meklort/kestrel-versa-adapter/kestrel.kicad_pcb

## KiCad design kestrel.kicad_pcb (2021-04-24)

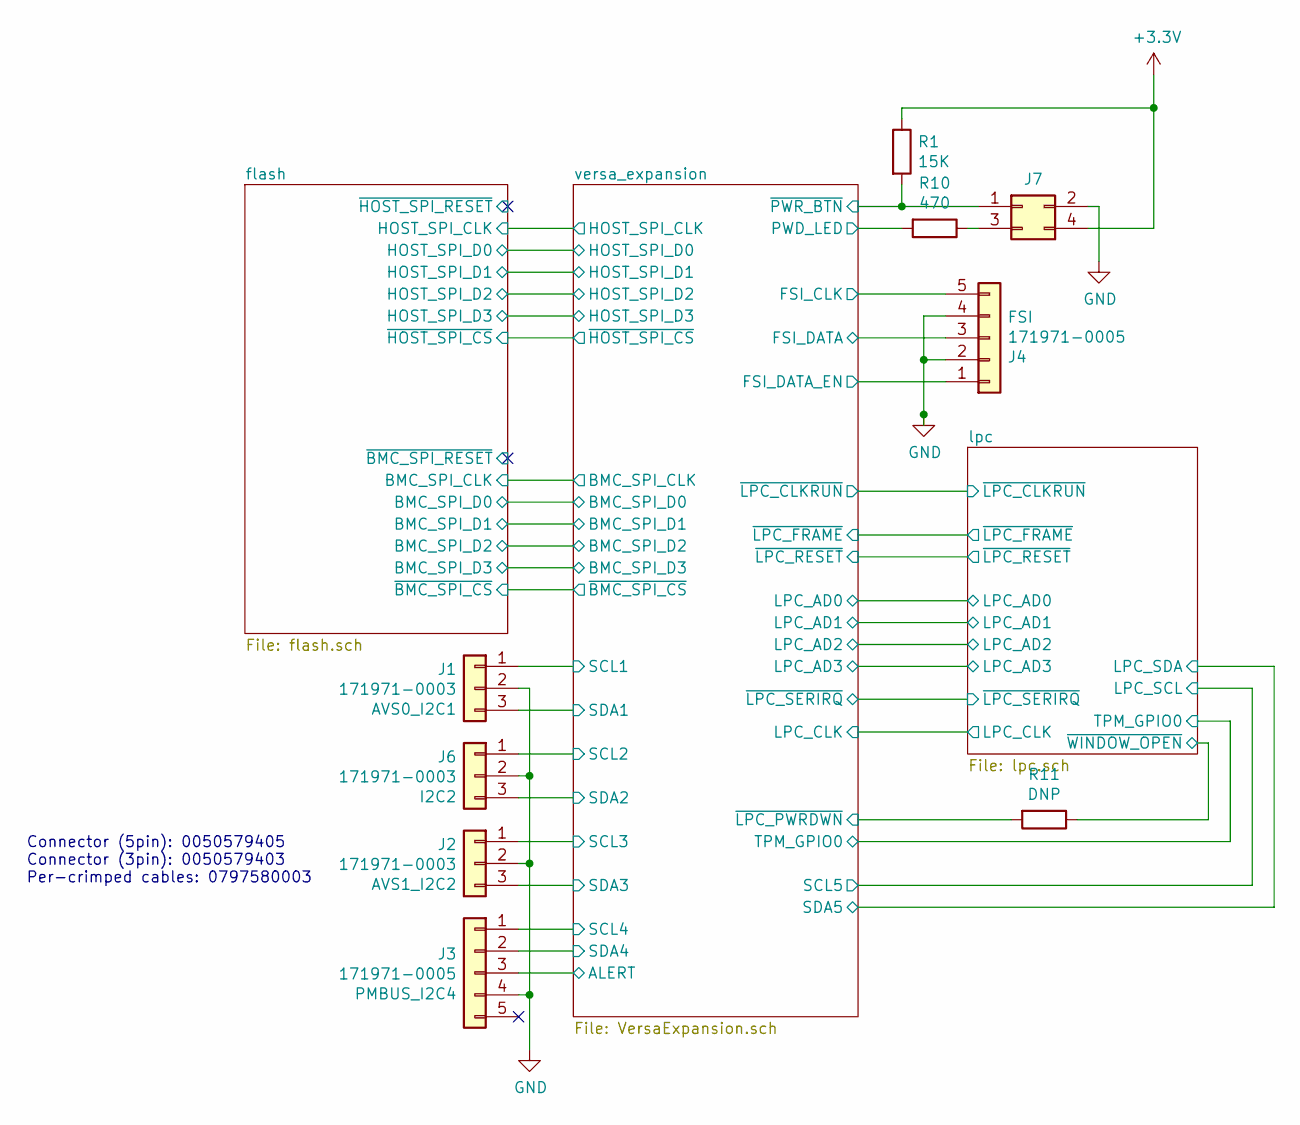
[picture p1: schematic kestrel.sch, Kestrel Versa-5G Adapter]

Parts:
J1, J2, J6: 171971-0003; Molex_SL_171971-0003_1x03_P2.54mm_Vertical
J3, J4: 171971-0005; Molex_SL_171971-0005_1x05_P2.54mm_Vertical
J7: Conn_02x02_Odd_Even; PinHeader_2x02_P2.54mm_Vertical
R1: 15K; R_0603_1608Metric_Pad0.98x0.95mm_HandSolder
R10: 470; R_0603_1608Metric_Pad0.98x0.95mm_HandSolder
R11: DNP; R_0603_1608Metric_Pad0.98x0.95mm_HandSolder

Connections:
+3V3: J7.4, R1.1; also elsewhere on the board
/lpc/~WINDOW_OPEN~: R11.1; also elsewhere on the board
/versa_expansion/ALERT: J3.3; also elsewhere on the board
/versa_expansion/FSI_CLK: J4.5; also elsewhere on the board
/versa_expansion/FSI_DATA: J4.3; also elsewhere on the board
/versa_expansion/FSI_DATA_EN: J4.1; also elsewhere on the board
/versa_expansion/PWD_LED: R10.2; also elsewhere on the board
/versa_expansion/SCL1: J1.1; also elsewhere on the board
/versa_expansion/SCL2: J6.1; also elsewhere on the board
/versa_expansion/SCL3: J2.1; also elsewhere on the board
/versa_expansion/SCL4: J3.1; also elsewhere on the board
/versa_expansion/SDA1: J1.3; also elsewhere on the board
/versa_expansion/SDA2: J6.3; also elsewhere on the board
/versa_expansion/SDA3: J2.3; also elsewhere on the board
/versa_expansion/SDA4: J3.2; also elsewhere on the board
/versa_expansion/~LPC_PWRDWN~: R11.2; also elsewhere on the board
/versa_expansion/~PWR_BTN~: J7.1, R1.2; also elsewhere on the board
GND: J1.2, J2.2, J3.4, J4.2, J4.4, J6.2, J7.2; also elsewhere on the board
unnamed: J7.3, R10.1

Notes on the sheet:
Connector (5pin): 0050579405 Connector (3pin): 0050579403 Per-crimped cables: 0797580003

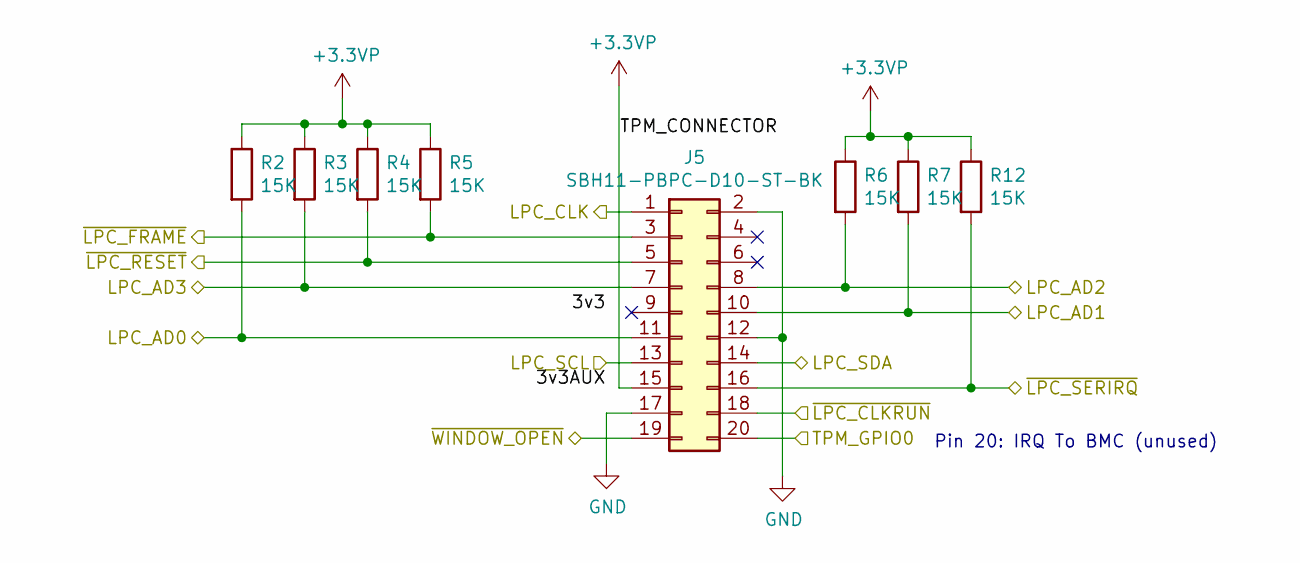
[picture p2: schematic lpc.sch, LPC Connector]

Parts:
J5: SBH11-PBPC-D10-ST-BK; PinHeader_2x10_P2.54mm_Vertical
R2, R3, R4, R5, R6, R7, R12: 15K; R_0603_1608Metric_Pad0.98x0.95mm_HandSolder

Connections:
+3.3VP: J5.15, R2.1, R3.1, R4.1, R5.1, R6.1, R7.1, R12.1
/lpc/LPC_AD0: J5.11, R2.2; also elsewhere on the board
/lpc/LPC_AD1: J5.10, R7.2; also elsewhere on the board
/lpc/LPC_AD2: J5.8, R6.2; also elsewhere on the board
/lpc/LPC_AD3: J5.7, R3.2; also elsewhere on the board
/lpc/LPC_CLK: J5.1; also elsewhere on the board
/lpc/LPC_SCL: J5.13; also elsewhere on the board
/lpc/LPC_SDA: J5.14; also elsewhere on the board
/lpc/TPM_GPIO0: J5.20; also elsewhere on the board
/lpc/~LPC_CLKRUN~: J5.18; also elsewhere on the board
/lpc/~LPC_FRAME~: J5.3, R5.2; also elsewhere on the board
/lpc/~LPC_RESET~: J5.5, R4.2; also elsewhere on the board
/lpc/~LPC_SERIRQ~: J5.16, R12.2; also elsewhere on the board
/lpc/~WINDOW_OPEN~: J5.19; also elsewhere on the board
GND: J5.2, J5.12, J5.17; also elsewhere on the board

Notes on the sheet:
Pin 20: IRQ To BMC (unused)

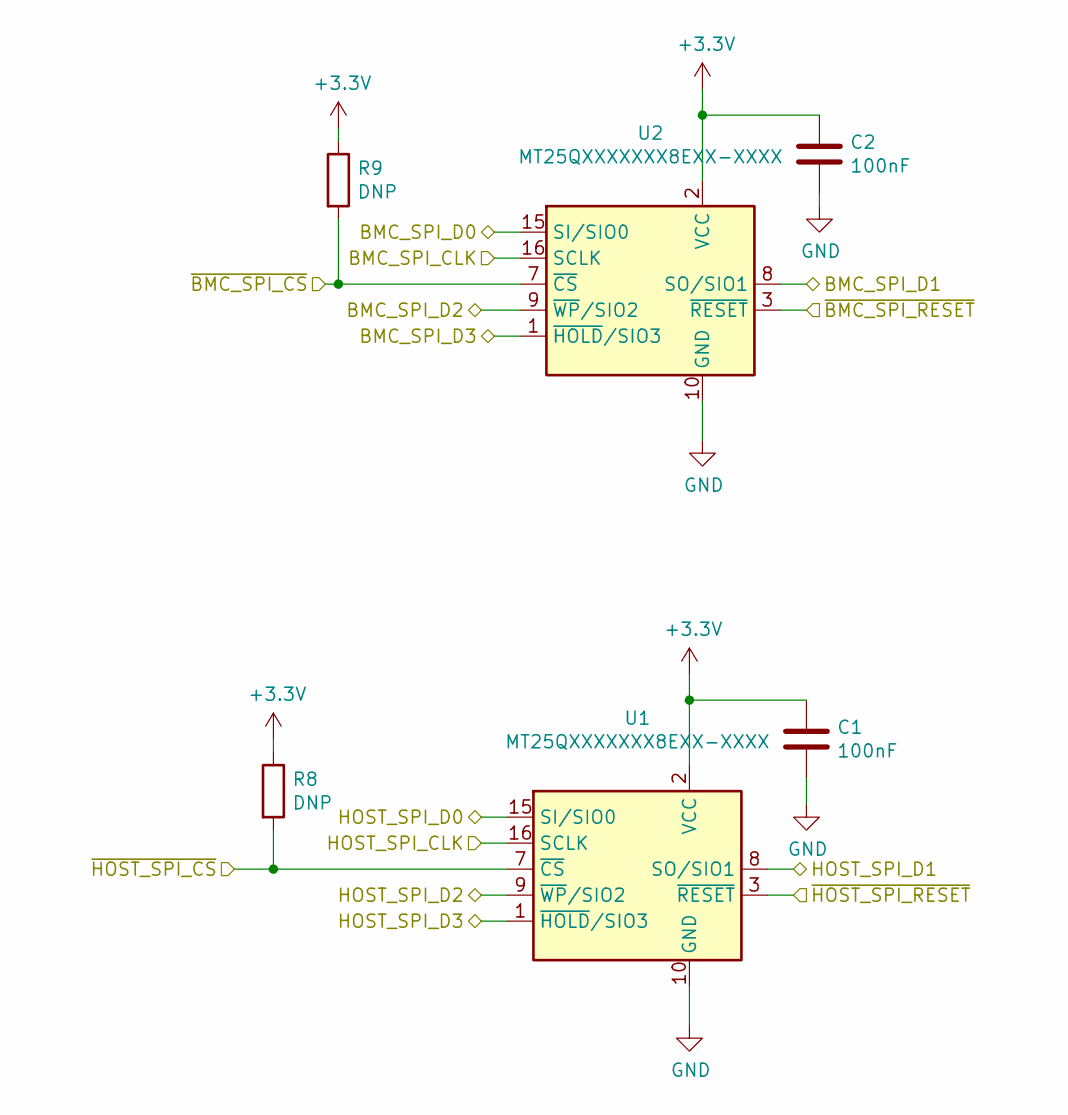
[picture p3: schematic flash.sch, BMC and Host Flash]

Parts:
C1, C2: 100nF; C_0603_1608Metric_Pad1.08x0.95mm_HandSolder
R8, R9: DNP; R_0603_1608Metric_Pad0.98x0.95mm_HandSolder
U1, U2: MT25QXXXXXXX8EXX-XXXX; SOIC-16W_7.5x10.3mm_P1.27mm

Connections:
+3V3: C1.1, C2.1, R8.1, R9.1, U1.2 (VCC), U2.2 (VCC); also elsewhere on the board
/flash/BMC_SPI_CLK: U2.16 (SCLK); also elsewhere on the board
/flash/BMC_SPI_D0: U2.15 (SI/SIO0); also elsewhere on the board
/flash/BMC_SPI_D1: U2.8 (SO/SIO1); also elsewhere on the board
/flash/BMC_SPI_D2: U2.9 (~WP~/SIO2); also elsewhere on the board
/flash/BMC_SPI_D3: U2.1 (~HOLD~/SIO3); also elsewhere on the board
/flash/HOST_SPI_CLK: U1.16 (SCLK); also elsewhere on the board
/flash/HOST_SPI_D0: U1.15 (SI/SIO0); also elsewhere on the board
/flash/HOST_SPI_D1: U1.8 (SO/SIO1); also elsewhere on the board
/flash/HOST_SPI_D2: U1.9 (~WP~/SIO2); also elsewhere on the board
/flash/HOST_SPI_D3: U1.1 (~HOLD~/SIO3); also elsewhere on the board
/flash/~BMC_SPI_CS~: R9.2, U2.7 (~CS); also elsewhere on the board
/flash/~BMC_SPI_RESET~: U2.3 (~RESET~)
/flash/~HOST_SPI_CS~: R8.2, U1.7 (~CS); also elsewhere on the board
/flash/~HOST_SPI_RESET~: U1.3 (~RESET~)
GND: C1.2, C2.2, U1.10 (GND), U2.10 (GND); also elsewhere on the board

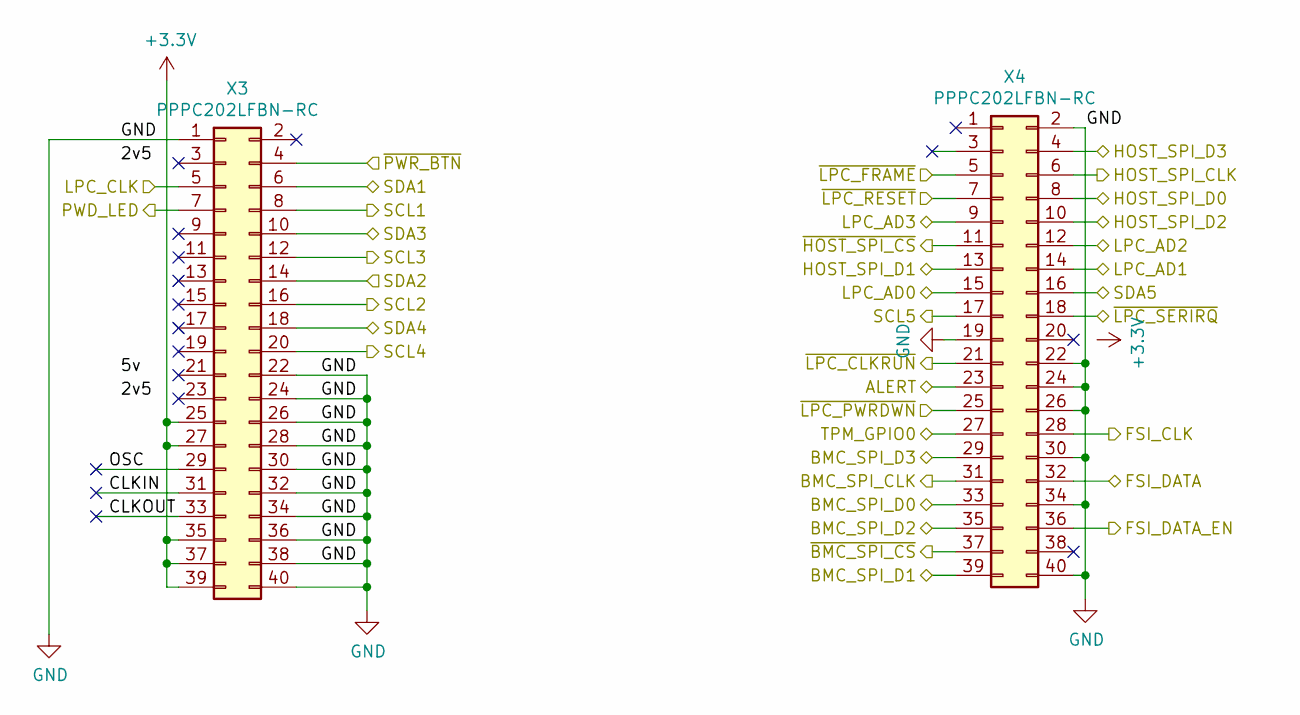
[picture p4: schematic VersaExpansion.sch, Versa Expansion]

Parts:
X3, X4: PPPC202LFBN-RC; PinHeader_2x20_P2.54mm_Vertical

Connections:
+3V3: X3.25, X3.27, X3.35, X3.37, X3.39; also elsewhere on the board
/flash/BMC_SPI_CLK: X4.31; also elsewhere on the board
/flash/BMC_SPI_D0: X4.33; also elsewhere on the board
/flash/BMC_SPI_D1: X4.39; also elsewhere on the board
/flash/BMC_SPI_D2: X4.35; also elsewhere on the board
/flash/BMC_SPI_D3: X4.29; also elsewhere on the board
/flash/HOST_SPI_CLK: X4.6; also elsewhere on the board
/flash/HOST_SPI_D0: X4.8; also elsewhere on the board
/flash/HOST_SPI_D1: X4.13; also elsewhere on the board
/flash/HOST_SPI_D2: X4.10; also elsewhere on the board
/flash/HOST_SPI_D3: X4.4; also elsewhere on the board
/flash/~BMC_SPI_CS~: X4.37; also elsewhere on the board
/flash/~HOST_SPI_CS~: X4.11; also elsewhere on the board
/lpc/LPC_AD0: X4.15; also elsewhere on the board
/lpc/LPC_AD1: X4.14; also elsewhere on the board
/lpc/LPC_AD2: X4.12; also elsewhere on the board
/lpc/LPC_AD3: X4.9; also elsewhere on the board
/lpc/LPC_CLK: X3.5; also elsewhere on the board
/lpc/LPC_SCL: X4.17; also elsewhere on the board
/lpc/LPC_SDA: X4.16; also elsewhere on the board
/lpc/TPM_GPIO0: X4.27; also elsewhere on the board
/lpc/~LPC_CLKRUN~: X4.21; also elsewhere on the board
/lpc/~LPC_FRAME~: X4.5; also elsewhere on the board
/lpc/~LPC_RESET~: X4.7; also elsewhere on the board
/lpc/~LPC_SERIRQ~: X4.18; also elsewhere on the board
/versa_expansion/ALERT: X4.23; also elsewhere on the board
/versa_expansion/CLKIN: X3.31
/versa_expansion/CLKOUT: X3.33
/versa_expansion/FSI_CLK: X4.28; also elsewhere on the board
/versa_expansion/FSI_DATA: X4.32; also elsewhere on the board
/versa_expansion/FSI_DATA_EN: X4.36; also elsewhere on the board
/versa_expansion/OSC: X3.29
/versa_expansion/PWD_LED: X3.7; also elsewhere on the board
/versa_expansion/SCL1: X3.8; also elsewhere on the board
/versa_expansion/SCL2: X3.16; also elsewhere on the board
/versa_expansion/SCL3: X3.12; also elsewhere on the board
/versa_expansion/SCL4: X3.20; also elsewhere on the board
/versa_expansion/SDA1: X3.6; also elsewhere on the board
/versa_expansion/SDA2: X3.14; also elsewhere on the board
/versa_expansion/SDA3: X3.10; also elsewhere on the board
/versa_expansion/SDA4: X3.18; also elsewhere on the board
/versa_expansion/~LPC_PWRDWN~: X4.25; also elsewhere on the board
/versa_expansion/~PWR_BTN~: X3.4; also elsewhere on the board
GND: X3.1, X3.22, X3.24, X3.26, X3.28, X3.30, X3.32, X3.34, X3.36, X3.38, X3.40, X4.2, X4.19, X4.22, X4.24, X4.26, X4.30, X4.34, X4.40; also elsewhere on the board

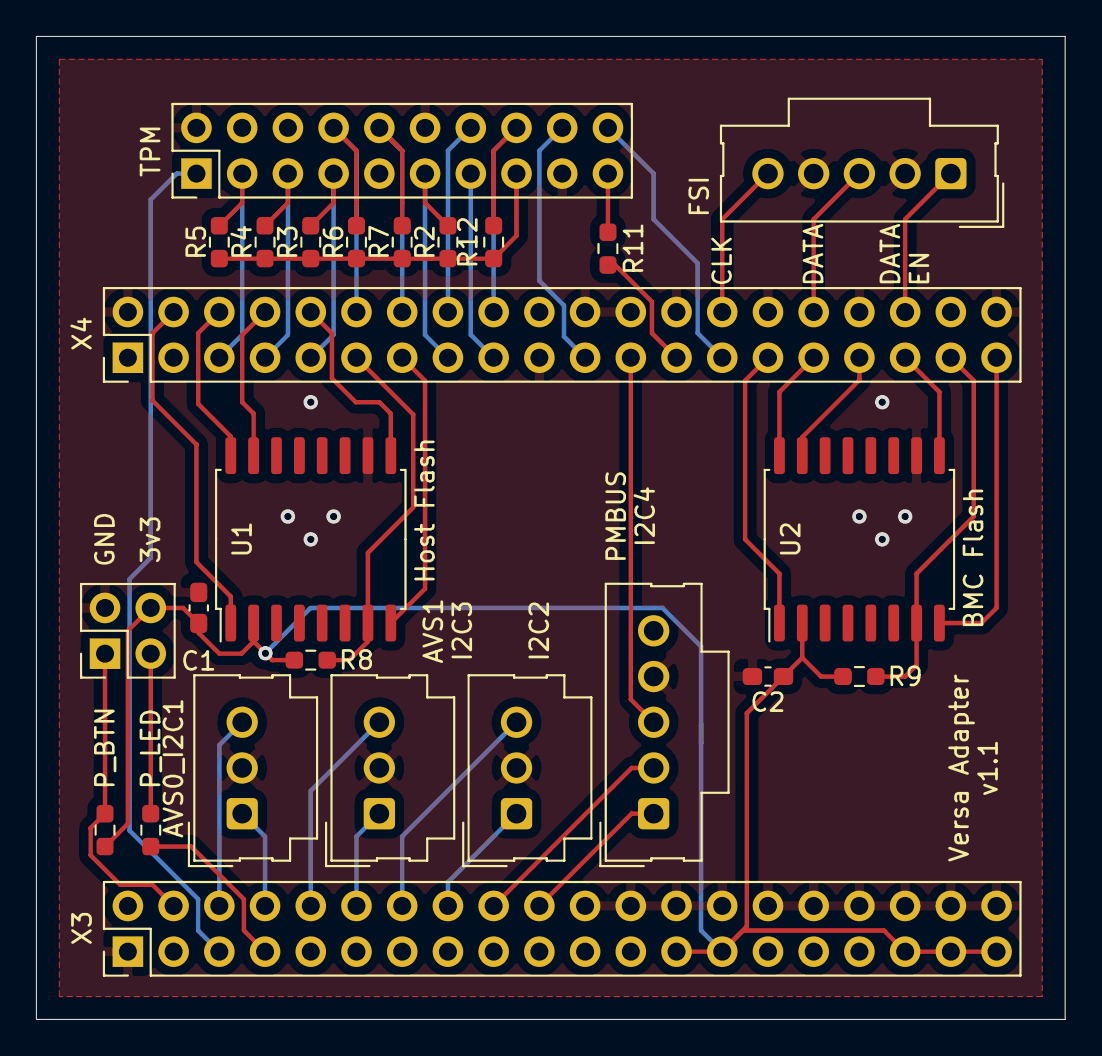
[picture p5: board kestrel.kicad_pcb from above]

Board: 2 copper layers, 57.2 x 54.6 mm, 25 parts (0 on the bottom side), 44 nets.
