meklort/kestrel-versa-adapter/(commit log)

2021-02-01 versa-adapter: Initial schematic
    [VersaExpansion.sch, flash.sch, fpga-pin-selection.ods, kestrel.kicad_pcb, kestrel.sch, lpc.sch]
2021-02-01 versa-adapter: Fix 3pin connector part number.
    [kestrel.sch]
2021-02-17 adapter: Update to version 1.1 with minor fixes found during testing.
    - Fix signal naming for host/bmc SPI_CSb and SPI_CLK.
    - Increase distance between FSI and TPM connector to allow for a shrowded TPM connector.
    - Move R8/R9 (unused) to updated Csb signal locations.
    - Fix silk screen for AVS1
    [VersaExpansion.sch, kestrel.kicad_pcb]
2021-04-24 v1.1: Connect LPC_CLK to A12 (was PWR_LED), add pull resistor for SERIRQ.
    [VersaExpansion.sch, fpga-pin-selection.ods, kestrel.kicad_pcb, lpc.sch]
